Pfannex/ESP8266-1W-I2C-Gateway/Eagle/ESP8266-1W-I2C-Gateway_V2.01.brd

## EAGLE design Eagle/ESP8266-1W-I2C-Gateway_V2.01.brd (2016-11-20)

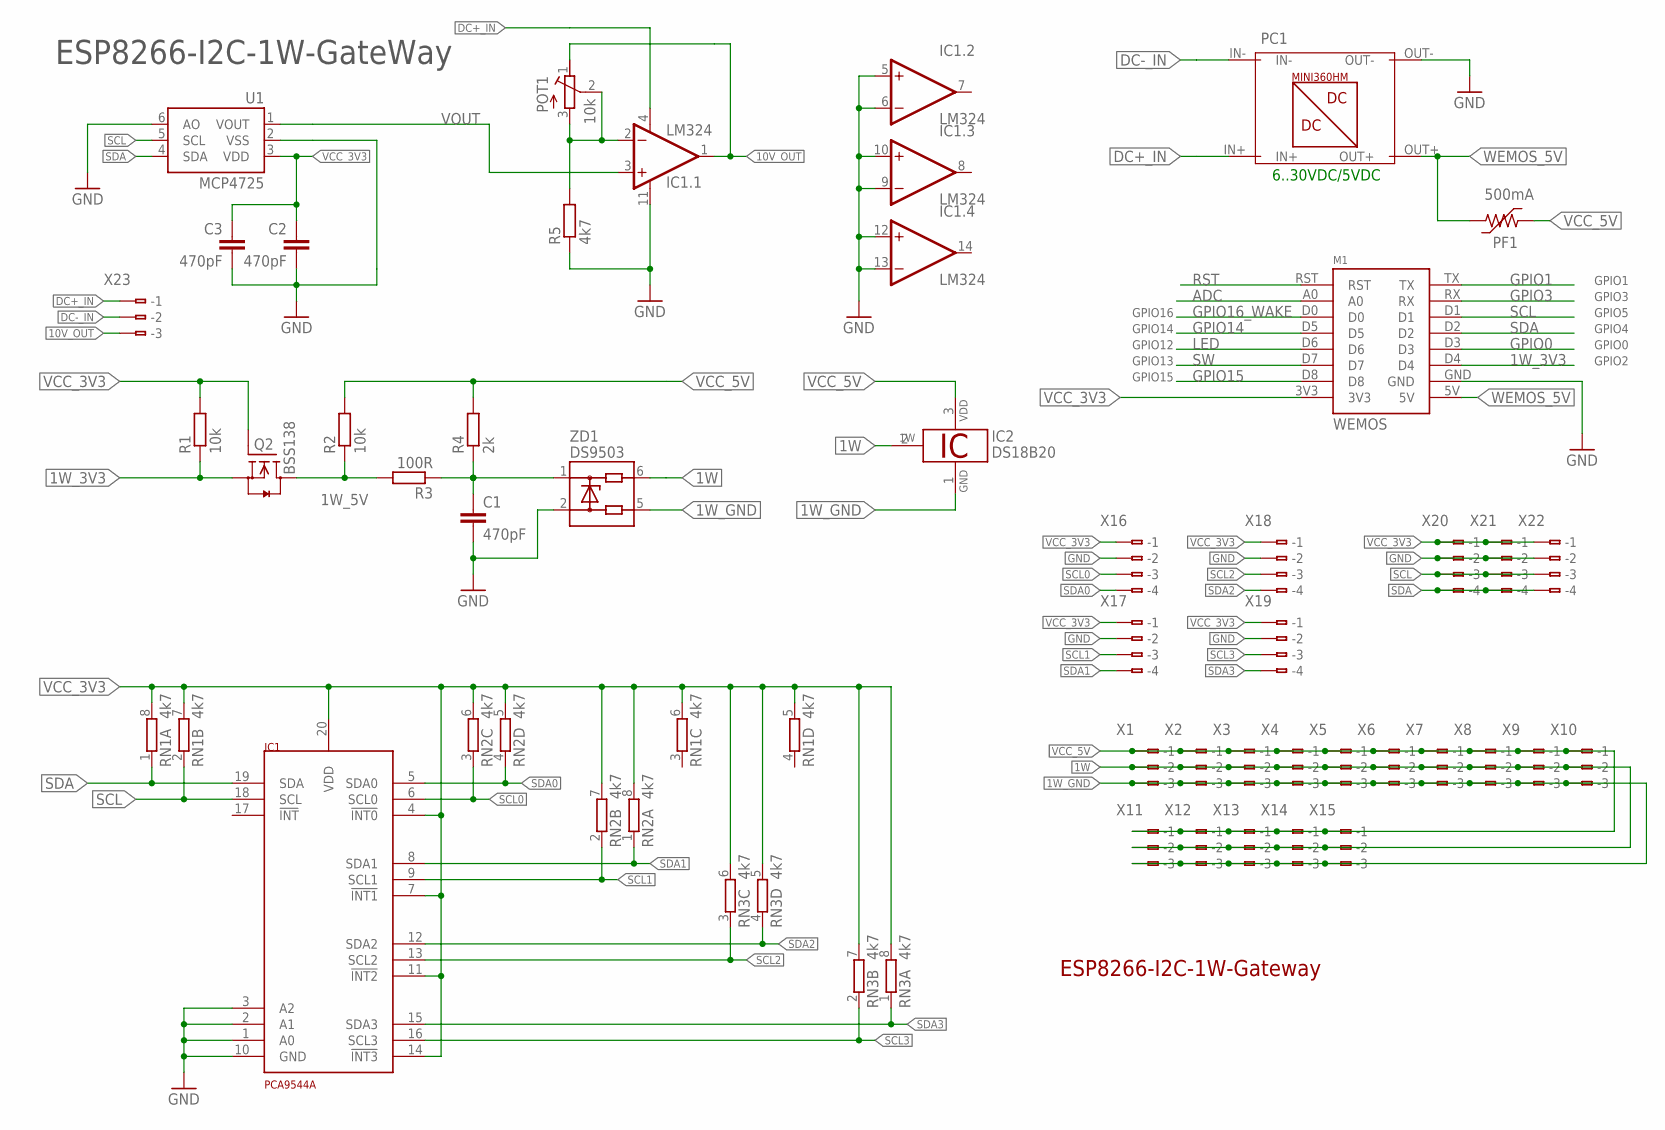
[picture p1: schematic ESP8266-1W-I2C-Gateway_V2.01.sch]

Parts:
C1, C2, C3: 470pF; C0805
IC1: PCA9544A; TSSOP20
IC1.: LM324; 2QSP14
IC2: DS18B20; TO92-
M1: WEMOS
PC1: MINI360HMTHROUGH-HOLE; MINI360HM
PF1: 500mA; F1206
POT1: 10k; BOURN_SMD_POTENTIOMETER
Q2: BSS138; SOT23
R1, R2: 10k; R0805
R3: 100R; R0805
R4: 2k; R0805
R5: 4k7; R0805
RN1, RN2, RN3: 4k7; 0603-ARC
U1: MCP4725; SOT23-6
X1, X2, X3, X4, X5, X6, X7, X8, X9, X10, X11, X12, X13, X14, X15, X23: MINI_3X
X16, X17, X18, X19, X20, X21, X22: MINI_4X
ZD1: DS9503; TSOC6_BYPASS_J

Connections:
1W: IC2.2 (1W), X1.B-2 (-2), X2.B-2 (-2), X3.B-2 (-2), X4.B-2 (-2), X5.B-2 (-2), X6.B-2 (-2), X7.B-2 (-2), X8.B-2 (-2), X9.B-2 (-2), X10.B-2 (-2), X11.B-2 (-2), X12.B-2 (-2), X13.B-2 (-2), X14.B-2 (-2), X15.B-2 (-2), ZD1.6
1W_3V3: M1.D4, Q2.2 (S), R1.1
1W_5V: Q2.3 (D), R2.1, R3.2
1W_GND: IC2.1 (GND), X1.B-3 (-3), X2.B-3 (-3), X3.B-3 (-3), X4.B-3 (-3), X5.B-3 (-3), X6.B-3 (-3), X7.B-3 (-3), X8.B-3 (-3), X9.B-3 (-3), X10.B-3 (-3), X11.B-3 (-3), X12.B-3 (-3), X13.B-3 (-3), X14.B-3 (-3), X15.B-3 (-3), ZD1.5
10V_OUT: IC1..1 (OUT), POT1.1 (A), X23.B-3 (-3)
ADC: M1.A0
DC+_IN: IC1..4 (V+), PC1.IN+, X23.B-1 (-1)
DC-_IN: PC1.IN-, X23.B-2 (-2)
GND: C1.2, C2.2, C3.2, IC1.1 (A0), IC1.2 (A1), IC1.3 (A2), IC1.10 (GND), IC1..5 (+IN), IC1..6 (-IN), IC1..9 (-IN), IC1..10 (+IN), IC1..11 (V-), IC1..12 (+IN), IC1..13 (-IN), M1.GND, PC1.OUT-, R5.1, U1.2 (VSS), U1.6 (AO), X16.B-2 (-2), X17.B-2 (-2), X18.B-2 (-2), X19.B-2 (-2), X20.B-2 (-2), X21.B-2 (-2), X22.B-2 (-2), ZD1.2
GPIO0: M1.D3
GPIO1: M1.TX
GPIO3: M1.RX
GPIO14: M1.D5
GPIO15: M1.D8
GPIO16_WAKE: M1.D0
LED: M1.D6
unnamed: IC1..2 (-IN), POT1.2 (S), POT1.3 (E), R5.2
unnamed: C1.1, R3.1, R4.1, ZD1.1
RST: M1.RST
SCL: IC1.18 (SCL), M1.D1, RN1.2 (1), U1.5 (SCL), X20.B-3 (-3), X21.B-3 (-3), X22.B-3 (-3)
SCL0: IC1.6 (SCL0), RN2.3 (1), X16.B-3 (-3)
SCL1: IC1.9 (SCL1), RN2.2 (1), X17.B-3 (-3)
SCL2: IC1.13 (SCL2), RN3.3 (1), X18.B-3 (-3)
SCL3: IC1.16 (SCL3), RN3.2 (1), X19.B-3 (-3)
SDA: IC1.19 (SDA), M1.D2, RN1.1, U1.4 (SDA), X20.B-4 (-4), X21.B-4 (-4), X22.B-4 (-4)
SDA0: IC1.5 (SDA0), RN2.4 (1), X16.B-4 (-4)
SDA1: IC1.8 (SDA1), RN2.1, X17.B-4 (-4)
SDA2: IC1.12 (SDA2), RN3.4 (1), X18.B-4 (-4)
SDA3: IC1.15 (SDA3), RN3.1, X19.B-4 (-4)
SW: M1.D7
VCC_3V3: C2.1, C3.1, IC1.4 (!INT0), IC1.7 (!INT1), IC1.11 (!INT2), IC1.14 (!INT3), IC1.20 (VDD), M1.3V3, Q2.1 (G), R1.2, RN1.5 (2), RN1.6 (2), RN1.7 (2), RN1.8 (2), RN2.5 (2), RN2.6 (2), RN2.7 (2), RN2.8 (2), RN3.5 (2), RN3.6 (2), RN3.7 (2), RN3.8 (2), U1.3 (VDD), X16.B-1 (-1), X17.B-1 (-1), X18.B-1 (-1), X19.B-1 (-1), X20.B-1 (-1), X21.B-1 (-1), X22.B-1 (-1)
VCC_5V: IC2.3 (VDD), PF1.1, R2.2, R4.2, X1.B-1 (-1), X2.B-1 (-1), X3.B-1 (-1), X4.B-1 (-1), X5.B-1 (-1), X6.B-1 (-1), X7.B-1 (-1), X8.B-1 (-1), X9.B-1 (-1), X10.B-1 (-1), X11.B-1 (-1), X12.B-1 (-1), X13.B-1 (-1), X14.B-1 (-1), X15.B-1 (-1)
VOUT: IC1..3 (+IN), U1.1 (VOUT)
WEMOS_5V: M1.5V, PC1.OUT+, PF1.2

Notes on the sheet:
ESP8266-I2C-1W-Gateway
ESP8266-I2C-1W-GateWay
GPIO16
GPIO5
GPIO4
GPIO0
GPIO2
GPIO14
GPIO12
GPIO13
GPIO15
GPIO3
GPIO1
6..30VDC/5VDC

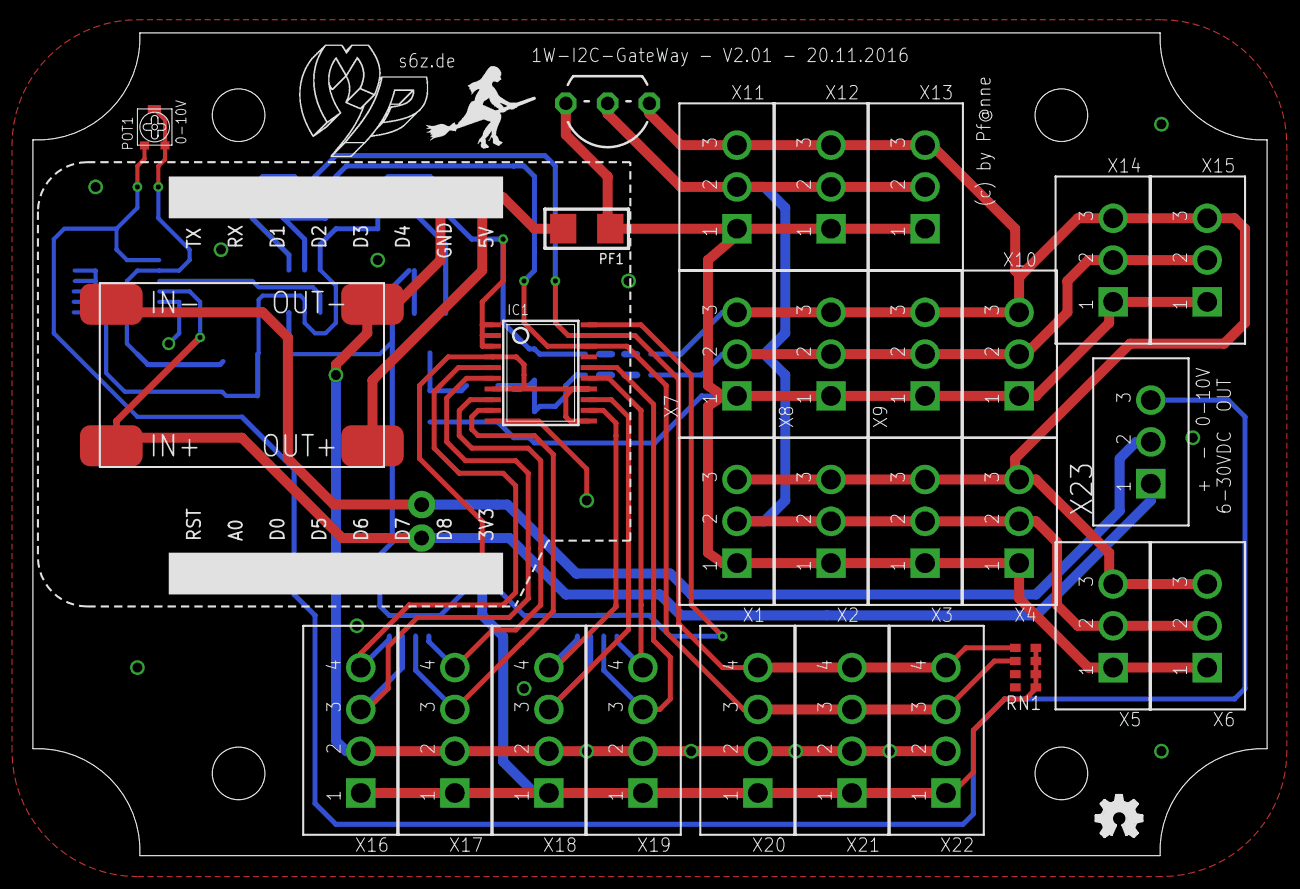
[picture p2: board ESP8266-1W-I2C-Gateway_V2.01.brd from above]

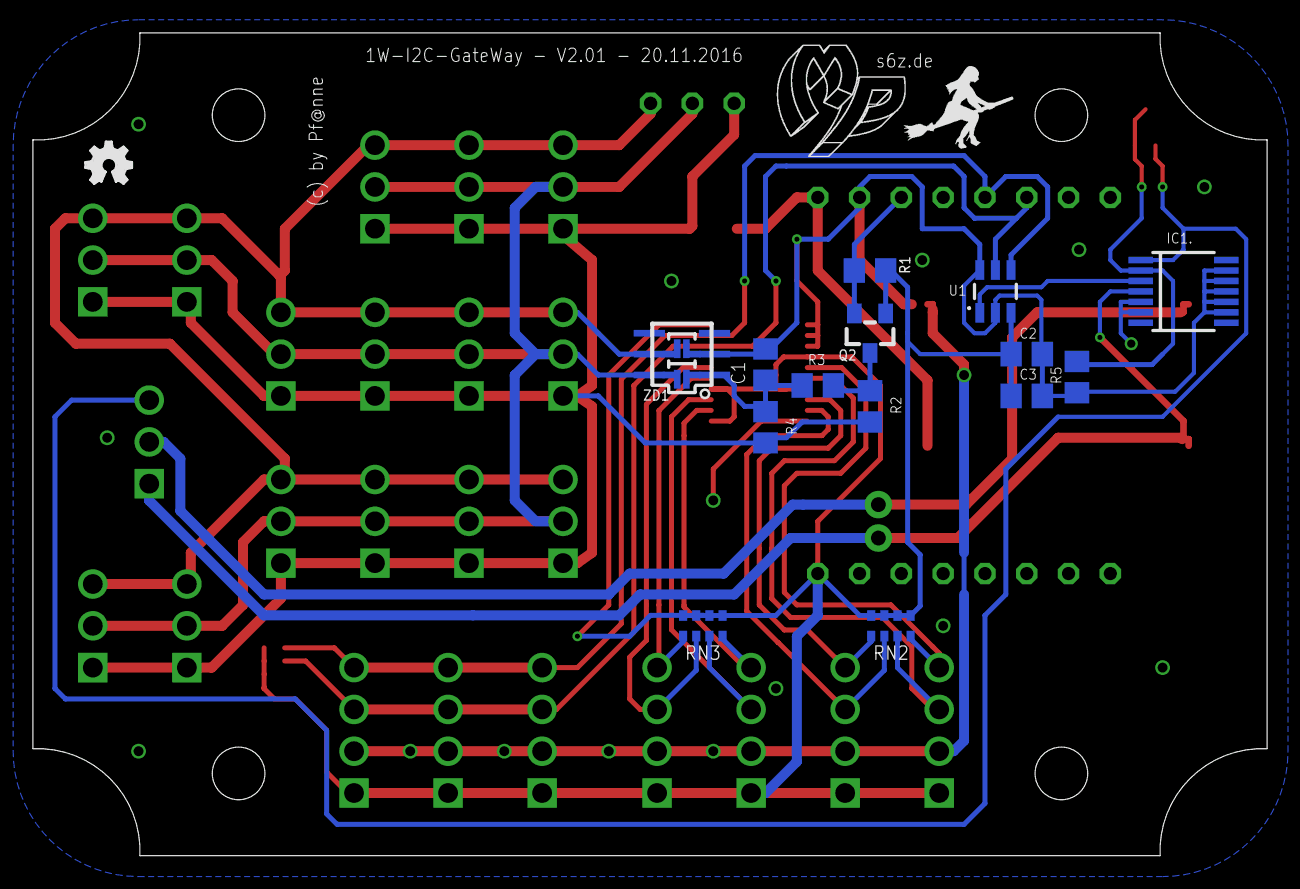
[picture p3: board ESP8266-1W-I2C-Gateway_V2.01.brd from below]

Board: 2 copper layers, 75.0 x 50.0 mm, 46 parts (15 on the bottom side), 24 nets.

Other parts of the board:
U$1, U$2: OSHW_FILLX100_NOTEXT
