Pfannex/ESP8266-1W-I2C-Gateway/(commit log)

2016-11-13 Upload Eagle
    [ESP8266-1W-I2C-Gateway_V2.00.brd, ESP8266-1W-I2C-Gateway_V2.00.sch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]
2016-11-20 Upload Eagle V2.01
    [ESP8266-1W-I2C-Gateway_V2.01.brd, ESP8266-1W-I2C-Gateway_V2.01.sch]
