Pfannex/ESP8266-1W-I2C-Gateway/(notices)

Notices in the files:
parts and their libraries:
polyswitch: Copyright (C) 2008, Bob Starr
SparkFun-AnalogIC: Licensing:Creative Commons ShareAlike 4.0 International - https://creativecommons.org/licenses/by-sa/4.0
